carlassaraf/tp_analyzer/hardware/devboard/devboard.kicad_pcb

## KiCad design hardware/devboard/devboard.kicad_pcb (2026-09-15)

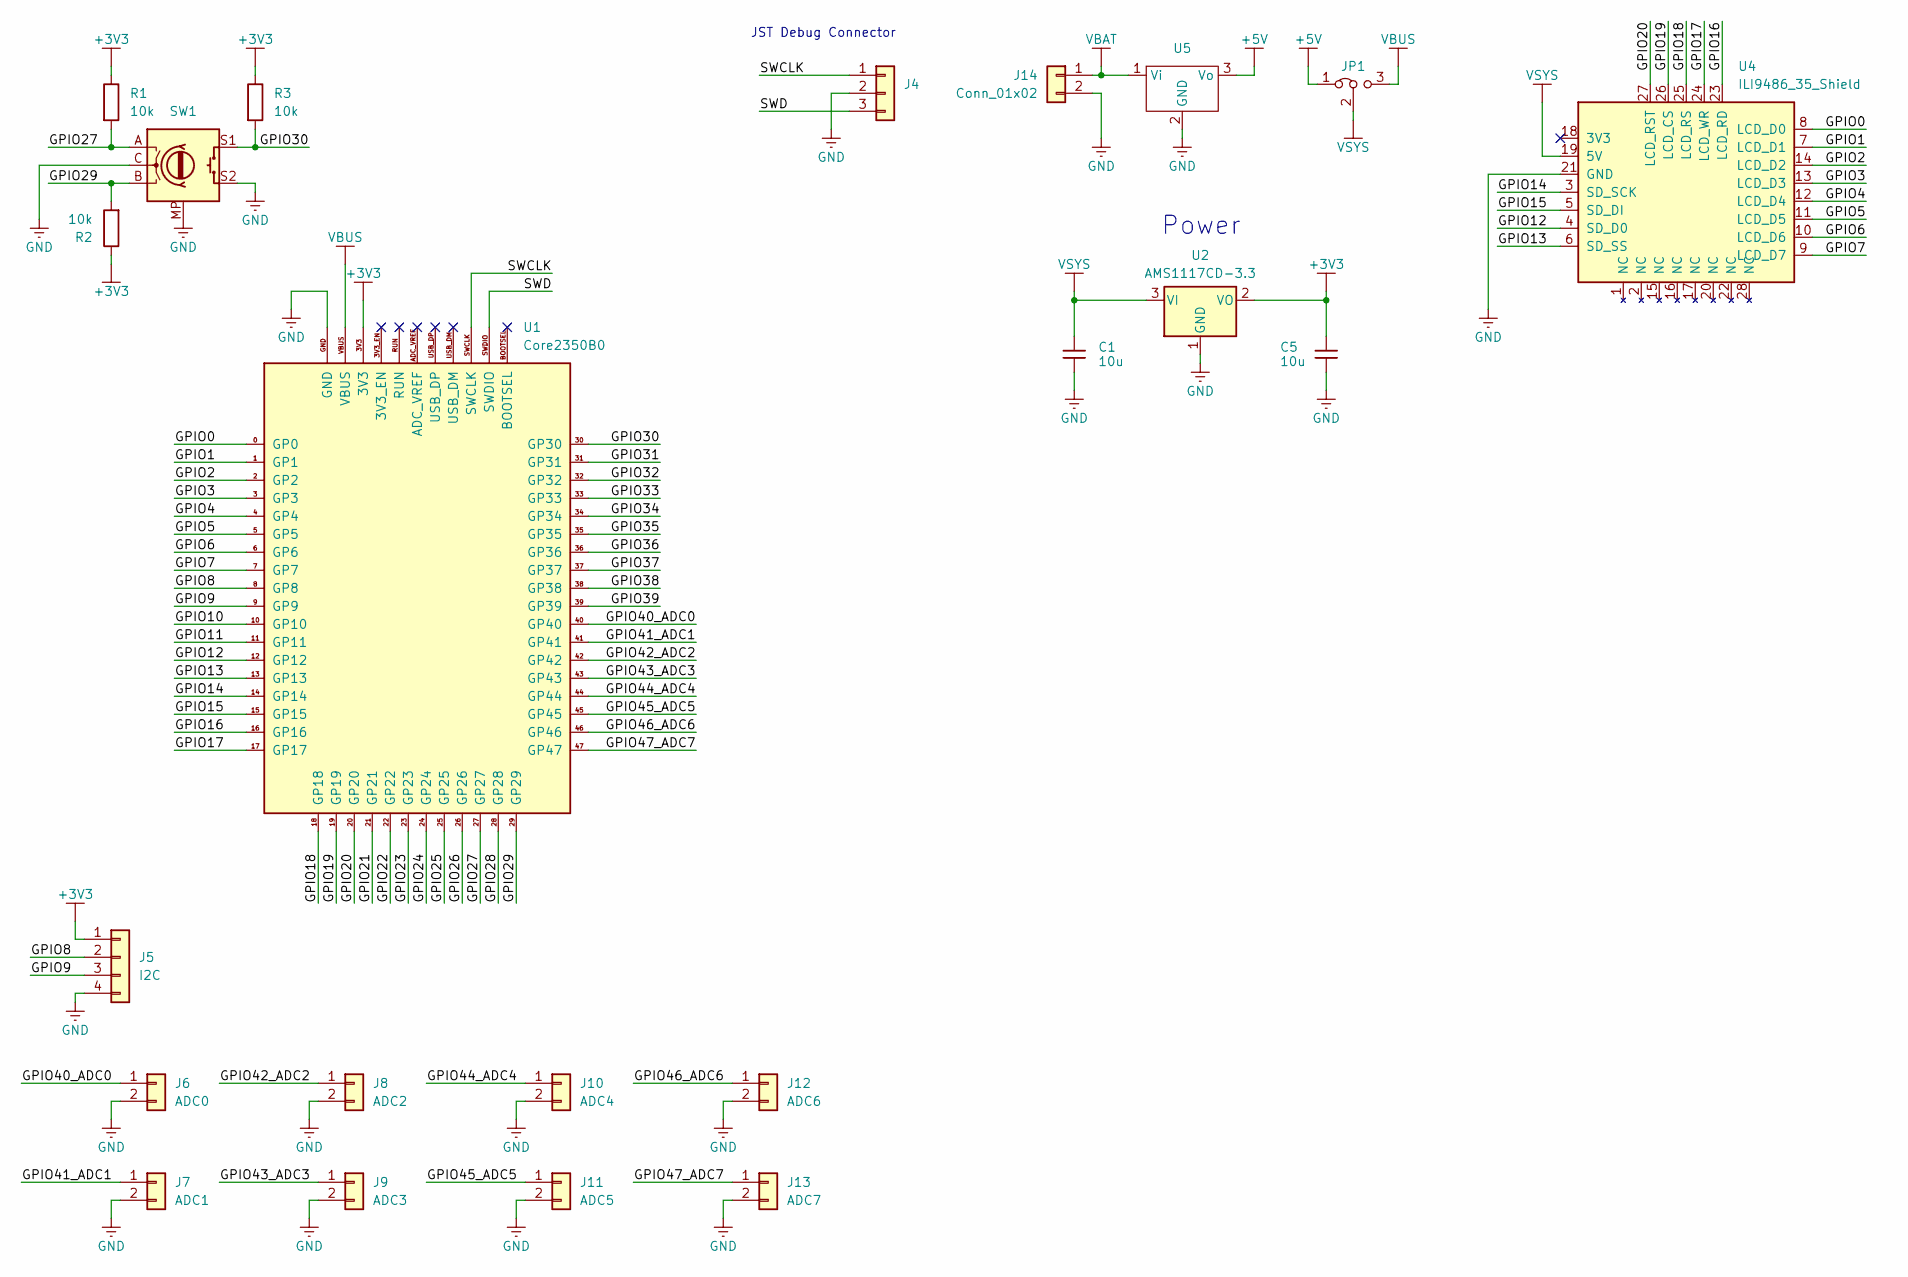
[picture p4: schematic devboard.kicad_sch, RP2350B Development Board]

Parts:
C1, C5: 10u; C_0603_1608Metric; voltage 16V; tolerance 10%; part_uid RP-01GYSK-AVBE41
J4: Conn_01x03; PinSocket_1x03_P2.54mm_Vertical
J5: I2C; PinSocket_1x04_P2.54mm_Vertical
J6: ADC0; PinSocket_1x02_P2.54mm_Vertical
J7: ADC1; PinSocket_1x02_P2.54mm_Vertical
J8: ADC2; PinSocket_1x02_P2.54mm_Vertical
J9: ADC3; PinSocket_1x02_P2.54mm_Vertical
J10: ADC4; PinSocket_1x02_P2.54mm_Vertical
J11: ADC5; PinSocket_1x02_P2.54mm_Vertical
J12: ADC6; PinSocket_1x02_P2.54mm_Vertical
J13: ADC7; PinSocket_1x02_P2.54mm_Vertical
J14: Conn_01x02; PinSocket_1x02_P2.54mm_Vertical
JP1: Jumper_3_Bridged12; PinSocket_1x03_P2.54mm_Vertical
R1, R2, R3: 10k; R_0805_2012Metric
SW1: RotaryEncoder_Switch_MP; RotaryEncoder_Alps_EC11E-Switch_Vertical_H20mm
U1: Core2350B0
U2: AMS1117CD-3.3; SOT-223-3_TabPin2
U4: ILI9486_35_Shield
U5: PinHeader_1x03_P2.54mm_Vertical

Connections:
+3V3: C5.1, J5.1, R1.1, R2.1, R3.1, U1.3V3, U2.2 (VO)
+5V: JP1.1 (A), U5.3 (Vo)
/GPIO0: U1.0 (GP0), U4.8 (LCD_D0)
/GPIO1: U1.1 (GP1), U4.7 (LCD_D1)
/GPIO2: U1.2 (GP2), U4.14 (LCD_D2)
/GPIO3: U1.3 (GP3), U4.13 (LCD_D3)
/GPIO4: U1.4 (GP4), U4.12 (LCD_D4)
/GPIO5: U1.5 (GP5), U4.11 (LCD_D5)
/GPIO6: U1.6 (GP6), U4.10 (LCD_D6)
/GPIO7: U1.7 (GP7), U4.9 (LCD_D7)
/GPIO8: J5.2, U1.8 (GP8)
/GPIO9: J5.3, U1.9 (GP9)
/GPIO10: U1.10 (GP10)
/GPIO11: U1.11 (GP11)
/GPIO12: U1.12 (GP12), U4.4 (SD_D0)
/GPIO13: U1.13 (GP13), U4.6 (SD_SS)
/GPIO14: U1.14 (GP14), U4.3 (SD_SCK)
/GPIO15: U1.15 (GP15), U4.5 (SD_DI)
/GPIO16: U1.16 (GP16), U4.23 (LCD_RD)
/GPIO17: U1.17 (GP17), U4.24 (LCD_WR)
/GPIO18: U1.18 (GP18), U4.25 (LCD_RS)
/GPIO19: U1.19 (GP19), U4.26 (LCD_CS)
/GPIO20: U1.20 (GP20), U4.27 (LCD_RST)
/GPIO21: U1.21 (GP21)
/GPIO22: U1.22 (GP22)
/GPIO23: U1.23 (GP23)
/GPIO24: U1.24 (GP24)
/GPIO25: U1.25 (GP25)
/GPIO26: U1.26 (GP26)
/GPIO27: R1.2, SW1.A, U1.27 (GP27)
/GPIO28: U1.28 (GP28)
/GPIO29: R2.2, SW1.B, U1.29 (GP29)
/GPIO30: R3.2, SW1.S1, U1.30 (GP30)
/GPIO31: U1.31 (GP31)
/GPIO32: U1.32 (GP32)
/GPIO33: U1.33 (GP33)
/GPIO34: U1.34 (GP34)
/GPIO35: U1.35 (GP35)
/GPIO36: U1.36 (GP36)
/GPIO37: U1.37 (GP37)
/GPIO38: U1.38 (GP38)
/GPIO39: U1.39 (GP39)
/GPIO40_ADC0: J6.1, U1.40 (GP40)
/GPIO41_ADC1: J7.1, U1.41 (GP41)
/GPIO42_ADC2: J8.1, U1.42 (GP42)
/GPIO43_ADC3: J9.1, U1.43 (GP43)
/GPIO44_ADC4: J10.1, U1.44 (GP44)
/GPIO45_ADC5: J11.1, U1.45 (GP45)
/GPIO46_ADC6: J12.1, U1.46 (GP46)
/GPIO47_ADC7: J13.1, U1.47 (GP47)
/SWCLK: J4.1, U1.SWCLK
/SWD: J4.3, U1.SWDIO
GND: C1.2, C5.2, J4.2, J5.4, J6.2, J7.2, J8.2, J9.2, J10.2, J11.2, J12.2, J13.2, J14.2, SW1.C, SW1.MP, SW1.S2, U1.GND, U2.1 (GND), U4.21 (GND), U5.2 (GND)
VBAT: J14.1, U5.1 (Vi)
VBUS: JP1.3 (B), U1.VBUS
VSYS: C1.1, JP1.2 (C), U2.3 (VI), U4.19 (5V)

Notes on the sheet:
JST Debug Connector
Power

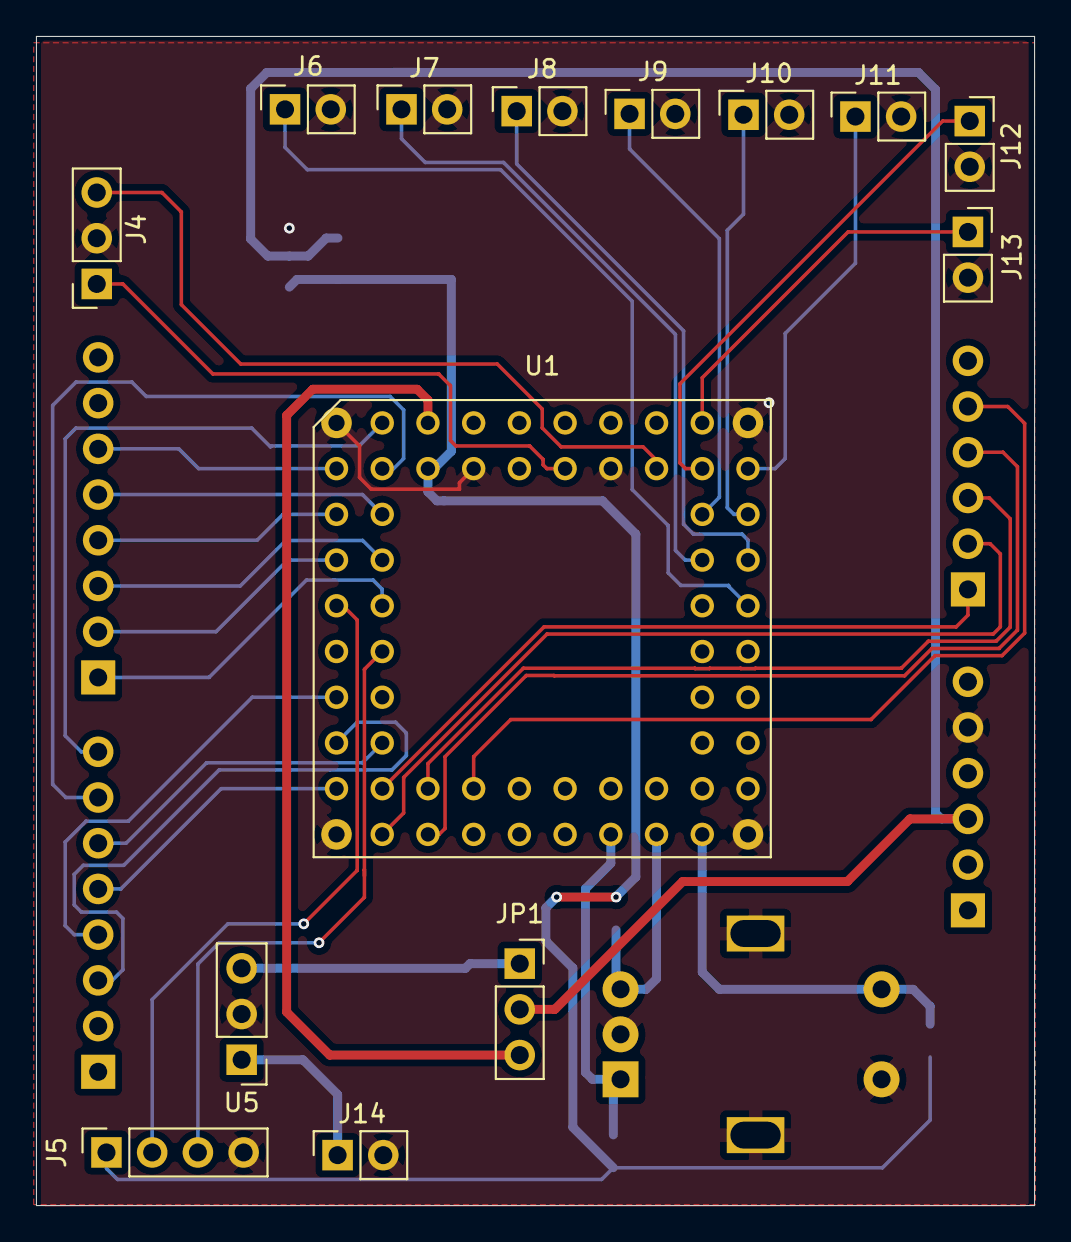
[picture p5: board devboard.kicad_pcb from above]

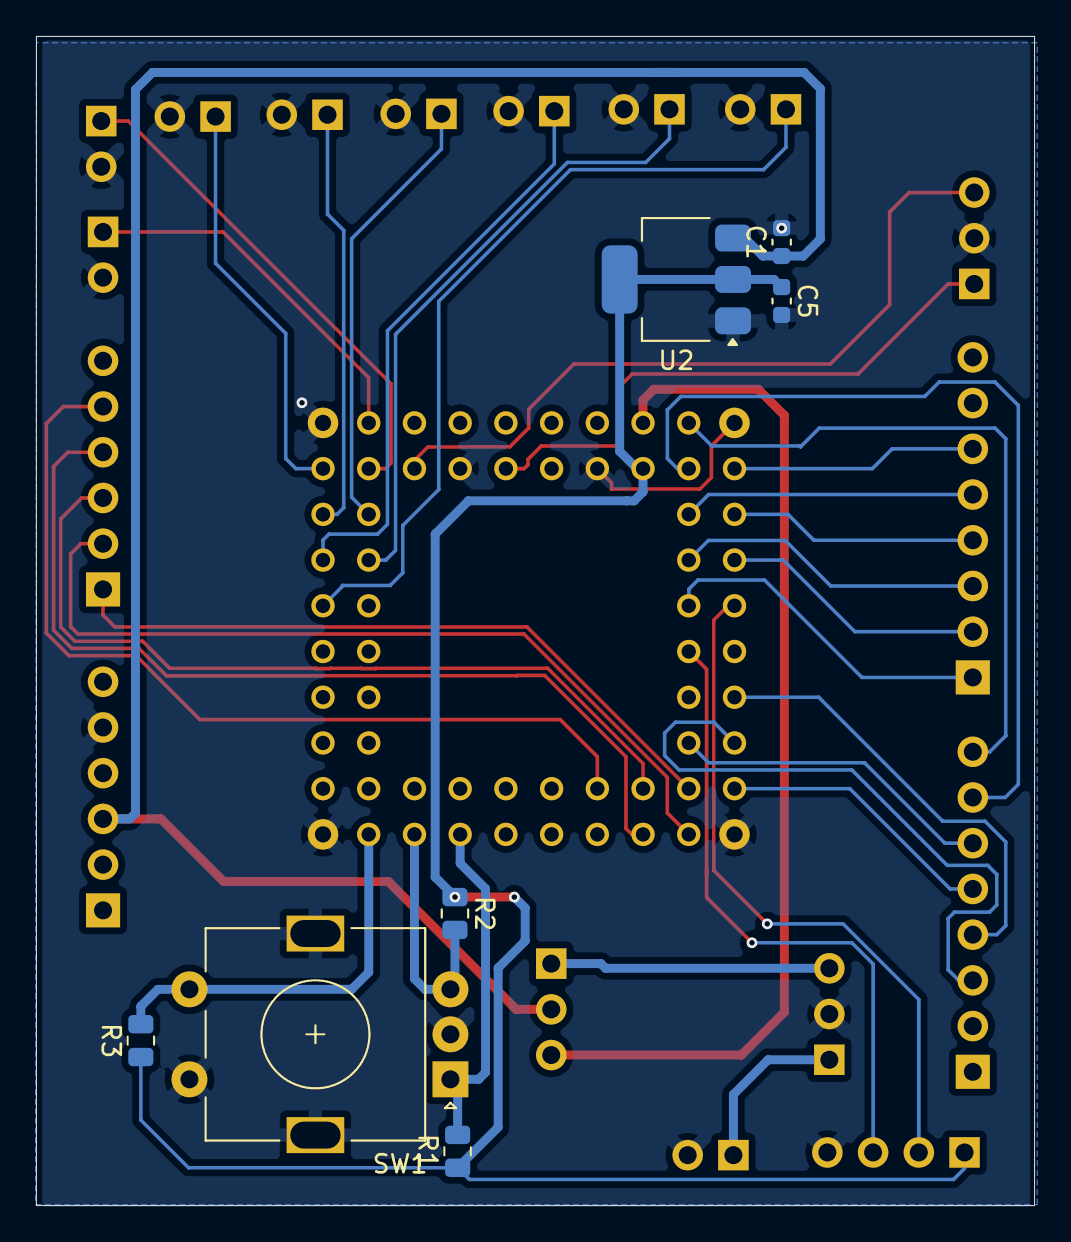
[picture p6: board devboard.kicad_pcb from below]

Board: 2 copper layers, 55.5 x 64.9 mm, 22 parts (7 on the bottom side), 38 nets.
