carlassaraf/tp_analyzer/(commit log)

2026-04-26 fix: wire freertos tick to lvgl tick
2026-04-26 feat: add encoder support
2026-04-27 feat: hal for ADC
2026-04-27 feat: add adc task with isr for dma
2026-04-27 test: tentative adc definitions
2026-05-05 fix: update pinout for pcb prototype
2026-05-29 perf: change gpio mask writing for PIO + DMA
2026-05-29 perf: move pio and dma to a hal
2026-06-10 feat: fft update from adc sampling
2026-06-10 feat: update fft chart and scroll bins with encoder
2026-06-10 feat: fft x ticks scroll with encoder
2026-06-15 feat: handle signal switching
2026-06-15 feat: update vertical scales and keep track of the last selected
2026-06-15 feat: update time scales in the UI on encoder interaction
2026-06-15 feat: update value labels from oscilloscope with ADC data
2026-06-17 fix: update screen update command names
    [ad_task.c]
2026-06-17 feat: initialize rtc and hold timer to update every minute
2026-06-17 feat: modify datetime and RTC with save button and restore labels when leaving screen
2026-06-20 perf(indev): use encoder difference rather than last activity time
2026-06-20 perf(display): add DMA to display flush to remove blocking operation
2026-06-20 perf(indev): increase encoder timer speed to read more frequently
2026-06-20 feat(dma): add completition irq for display
2026-06-20 perf(sampling): halve ADC samples
2026-08-12 feat(adc-dma): add custom driver
2026-08-13 test(adc): first adc driver test
2026-08-13 fix(adc): add source and destination for DMA
    [adc_stream_rpi_pico.c]
2026-08-14 feat(adc-dma): add ping-pong DMA support for multiple ADC channels
2026-08-14 chore(threads): reallocate and rename tasks directory
2026-08-17 fix(adc): disable built in ADC driver
2026-08-17 chore(adc): remove unused variable
2026-08-17 refactor(thread): migrate FreeRTOS tasks to Zephyr Threads
2026-08-17 feat(kconfig): add thread configurations in kconfig
2026-08-17 feat(ui): add UI thread for LVGL
2026-08-17 feat(adc): add dedicated ADC thread to poll messages from DMA
2026-08-17 refactor(timer): change FreeRTOS SoftwareTimer to static Zephyr timer
2026-08-17 feat(powman): add POWMAN RTC driver
2026-08-17 feat(app): make RTC driver available at application level
2026-08-17 feat(dt): add custom POWMAN node compatible with driver
2026-08-17 feat(rtc): set up RTC at UI init and get RTC datetime on Zephyr timer callback
2026-08-17 feat(dt): configure encoder in the devicetree
2026-08-17 feat(prj): enable input devices
2026-08-18 fix(stack): increase stack size for UI thread
2026-08-18 feat(encoder): add LVGL input group wired to encoder
2026-08-18 refactor(rtc): update RTC consumer with custom Zephyr driver
2026-08-18 refactor(settings): use new RTC driver
2026-08-18 refactor(datetime): use new RTC and encoder drivers
2026-08-18 feat(dt): get number of available channels from devicetree
2026-08-19 feat(library): add custom symbols and footprint for screen and MCU
2026-08-19 feat(devboard): first draft of schematic
    [RP2350B.kicad_sch, devboard.kicad_pcb, devboard.kicad_sch, power.kicad_sch]
2026-08-26 feat(dev_state): add a mutex protected common device state
2026-08-26 feat(timeout): add dev_state owned timers for timeouts
2026-08-26 feat(timeout): wire callback to timeout timer
2026-08-26 feat(dev_state): initialize shared device state before threads
2026-08-26 feat(timeout): reset timeout timers on encoder activity
2026-08-26 perf(encoder): reduce steps per period to have a 1 to 1 step
2026-09-15 feat(lib): add Core2350 symbol and footprint
2026-09-15 feat(sch): add first schematic draft
    [RP2350B.kicad_sch, devboard.kicad_sch, power.kicad_sch]
2026-09-15 feat(pcb): add first PCB for the devboard
    [devboard.kicad_pcb]
2026-09-15 feat(library): add custom inductor and boost footprints
2026-09-15 fix(lib): use relative library paths and align symbol library nickname
    - fp-lib-table: replace machine-specific absolute path with
    ${KIPRJMOD}/../lib/footprints.pretty so the project opens on any
    machine.
    - sym-lib-table: rename the "Project Library" nickname to
    "Project_Library" to match the lib_id references actually used by
    the schematic symbols (Project_Library:Core2350B0,
    Project_Library:Boost_5V, Project_Library:ILI9486_35_Shield), which
    otherwise fail to resolve. Footprint references use "Project Library"
    (with a space) so fp-lib-table's nickname is left unchanged.
2026-09-22 feat(mcp): add actual driver code
2026-09-22 feat(mcp): add cmakelists and kconfig for driver
2026-09-22 test(mcp): add sample to test MCP with shell
2026-10-03 feat(dts): add SPI pinctrl and mcp node
2026-10-03 feat(app): add mcp driver to application
